wshito/Micromouse2017/freecad/assembly.FCStd

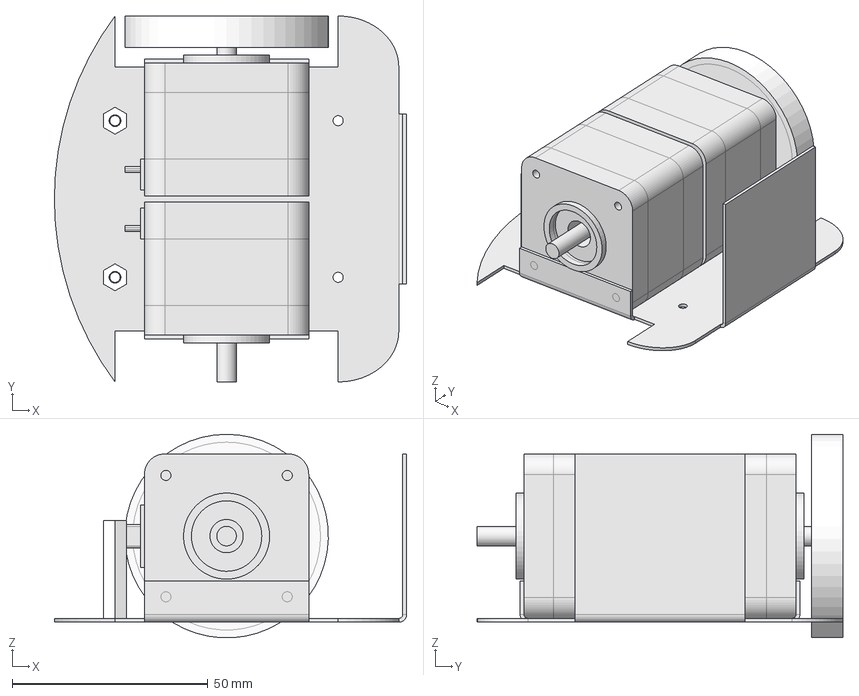
[picture p1: CAD file, 2017-05-07]
freecad/assembly.FCStd
90.0 x 93.5 x 52.0 mm
chassis_01
7PM_K044_left
7PM_K044_right
wheel_right
spacer_M3_25_right
spacer_M3_25_left
