wshito/Micromouse2017/freecad/spacer-M3-25.FCStd

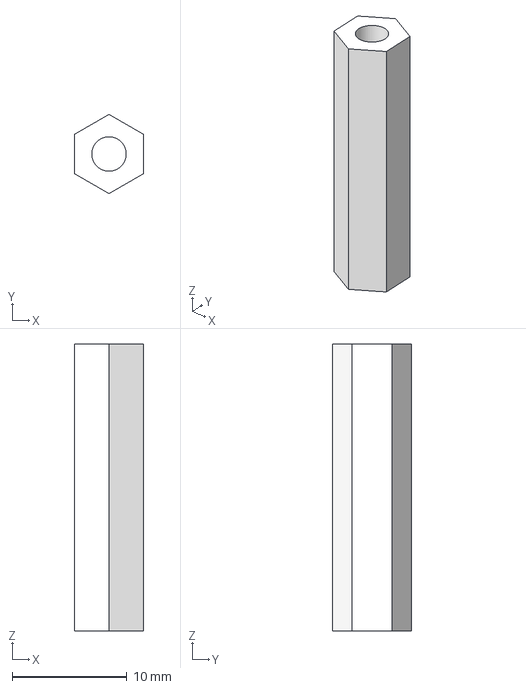
[picture p2: CAD file, 2017-05-07]
freecad/spacer-M3-25.FCStd
5.98 x 6.90 x 25.0 mm
