wshito/Micromouse2017/freecad/17PM-K044.FCStd

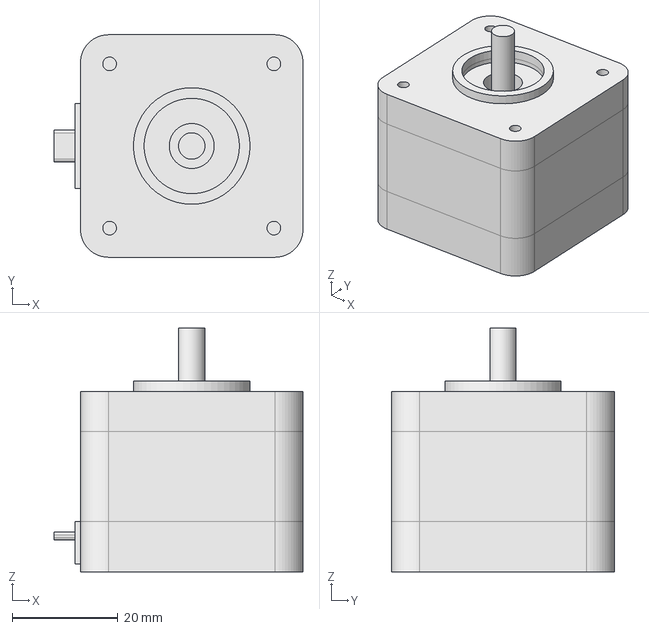
[picture p3: CAD file, 2017-05-07]
freecad/17PM-K044.FCStd
47.0 x 42.0 x 46.0 mm
