wshito/Micromouse2017/freecad/motor-mount.FCStd

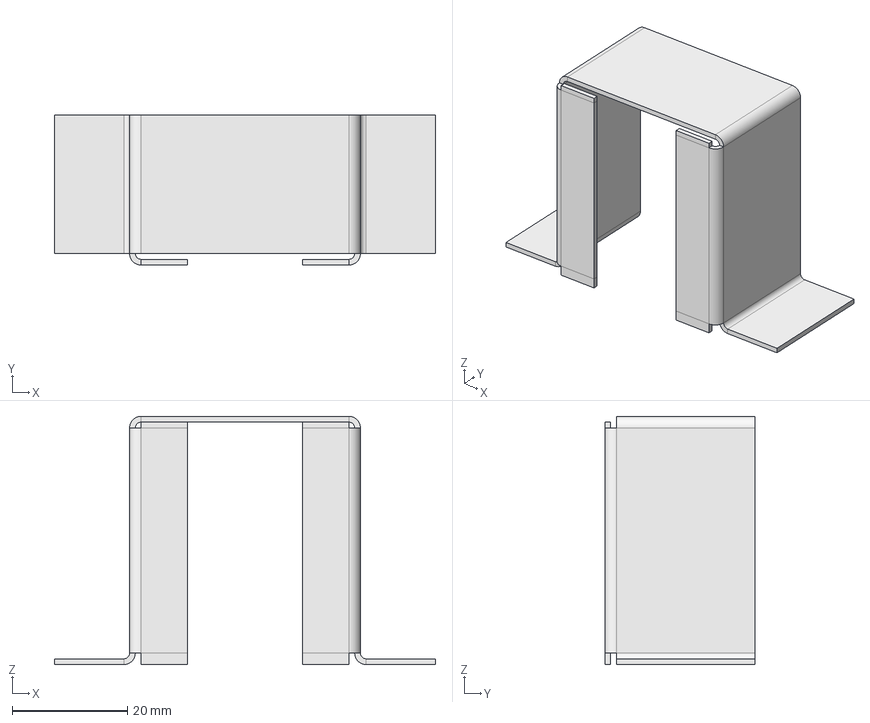
[picture p4: CAD file, 2017-05-06]
freecad/motor-mount.FCStd
66.0 x 26.0 x 43.0 mm
