wshito/Micromouse2017/freecad/chassis.FCStd

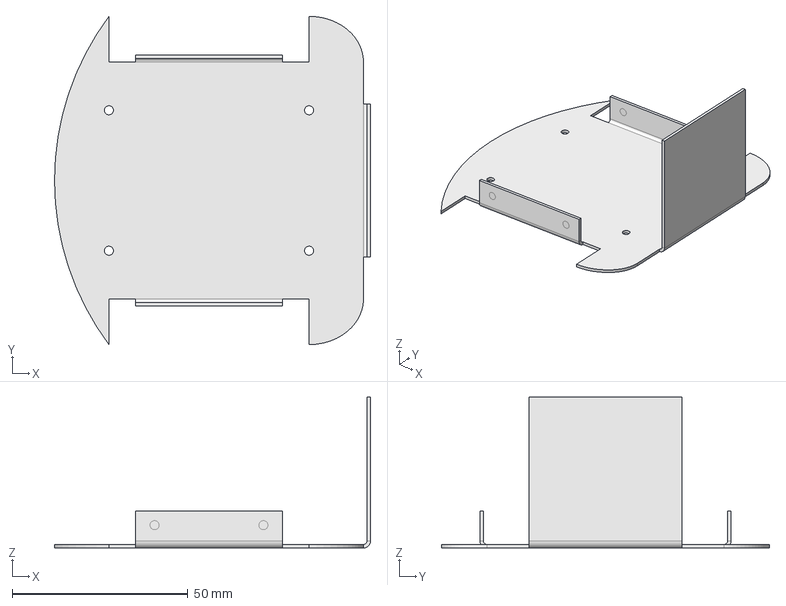
[picture p5: CAD file, 2017-05-06]
freecad/chassis.FCStd
90.0 x 93.5 x 43.0 mm
