wshito/Micromouse2017/freecad/wheel.FCStd

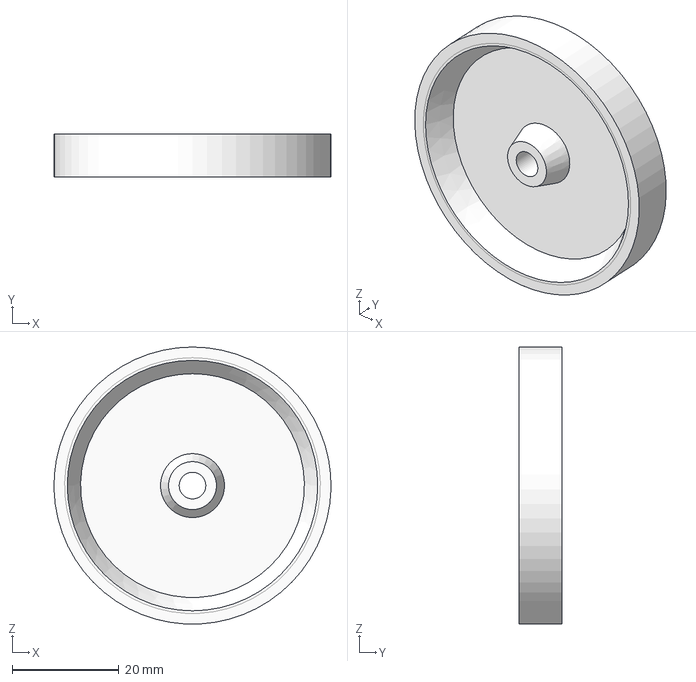
[picture p6: CAD file, 2017-05-06]
freecad/wheel.FCStd
52.0 x 8.00 x 52.0 mm
