wshito/Micromouse2017/prototype/a3982slb_board/kicad/a3982slb_board/output/board_layout.pdf

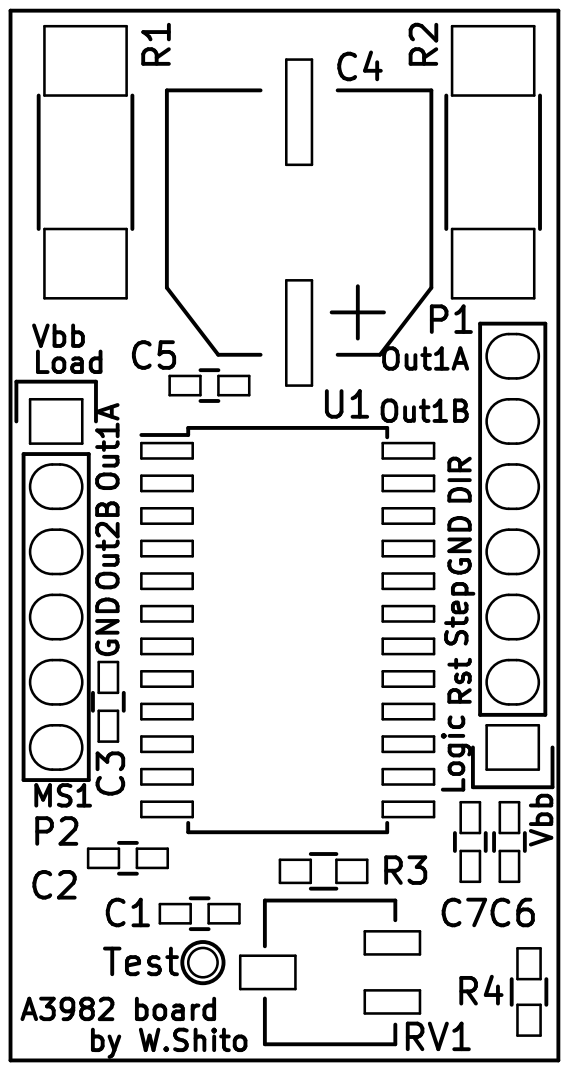
[picture p7: page 1]
