wshito/Micromouse2017/prototype/a3982slb_board/kicad/a3982slb_board/a3982slb_board.kicad_pcb

## KiCad design prototype/a3982slb_board/kicad/a3982slb_board/a3982slb_board.kicad_pcb (2017-07-03)

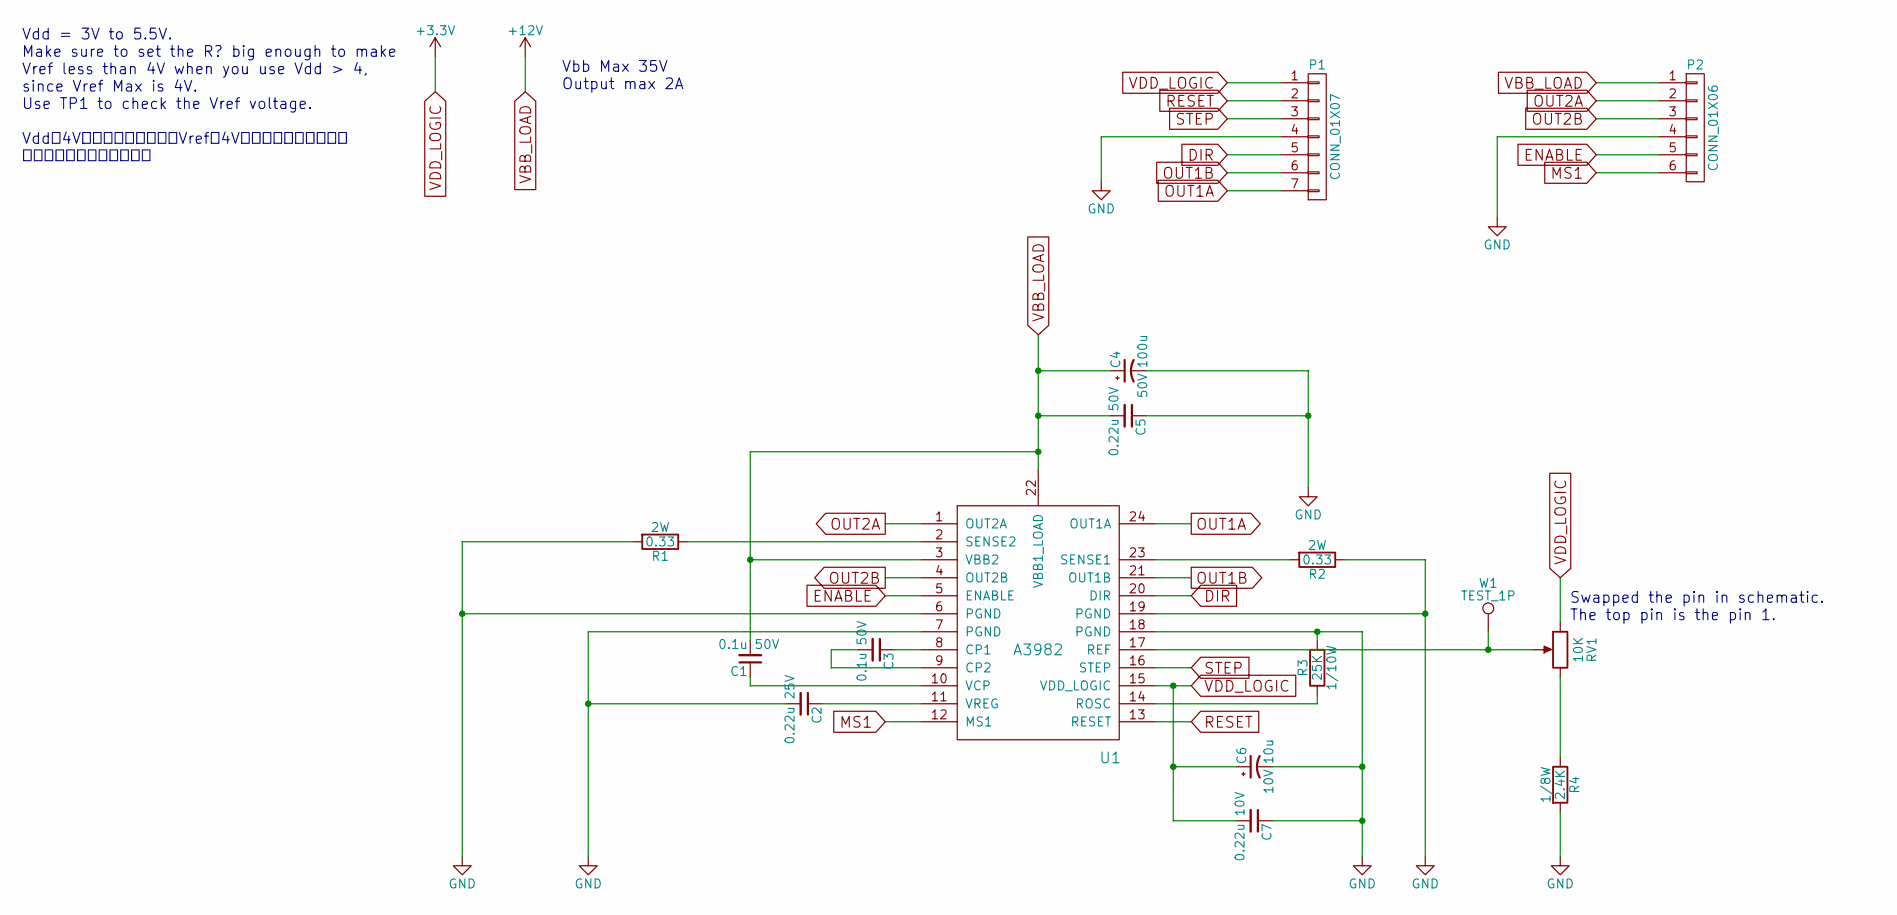
[picture p8: schematic a3982slb_board.sch, A3982 Evaluation Board]

Parts:
C1, C3: 0.1u; C_0603_HandSoldering; Voltage 50V
C2: 0.22u; C_0603_HandSoldering; Voltage 25V
C4: 100u; UCB1H101MNL1GS_HandSoldering; Voltage 50V
C5: 0.22u; C_0603_HandSoldering; Voltage 50V
C6: 10u; C_0603_HandSoldering; Voltage 10V
C7: 0.22u; C_0603_HandSoldering; Voltage 10V
P1: CONN_01X07; Pin_Header_Straight_1x07
P2: CONN_01X06; Pin_Header_Straight_1x06
R1, R2: 0.33; R_2512_HandSoldering
R3: 25K; R_0603_HandSoldering
R4: 2.4K; R_0603_HandSoldering
RV1: 10K; G43A
U1: A3982; SOIC-24W_7.5x15.4mm_Pitch1.27mm
W1: TEST_1P; Measurement_Point_Square-TH_Small

Connections:
DIR: P1.5, U1.20 (DIR)
ENABLE: P2.5, U1.5 (ENABLE)
GND: C2.2, C4.2, C5.1, C6.2, C7.1, P1.4, P2.4, R1.2, R2.1, R3.2, R4.2, U1.6 (PGND), U1.7 (PGND), U1.18 (PGND), U1.19 (PGND)
MS1: P2.6, U1.12 (MS1)
unnamed: C1.1, U1.10 (VCP)
unnamed: C2.1, U1.11 (VREG)
unnamed: C3.1, U1.8 (CP1)
unnamed: C3.2, U1.9 (CP2)
unnamed: R1.1, U1.2 (SENSE2)
unnamed: R2.2, U1.23 (SENSE1)
unnamed: R3.1, U1.14 (ROSC)
unnamed: R4.1, RV1.3
unnamed 12: RV1.2, U1.17 (REF), W1.1; also elsewhere on the board
OUT1A: P1.7, U1.24 (OUT1A)
OUT1B: P1.6, U1.21 (OUT1B)
OUT2A: P2.2, U1.1 (OUT2A)
OUT2B: P2.3, U1.4 (OUT2B)
RESET: P1.2, U1.13 (RESET)
STEP: P1.3, U1.16 (STEP)
VBB_LOAD: C1.2, C4.1, C5.2, P2.1, U1.3 (VBB2), U1.22 (VBB1_LOAD)
VDD_LOGIC: C6.1, C7.2, P1.1, RV1.1, U1.15 (VDD_LOGIC)

Notes on the sheet:
Vdd = 3V to 5.5V. Make sure to set the R? big enough to make Vref less than 4V when you use Vdd > 4, since Vref Max is 4V. Use TP1 to check the Vref voltage. Vddに4V以上印可する場合はVrefに4V以上印可しないように 可変抵抗を調節すること．
Vbb Max 35V Output max 2A
Swapped the pin in schematic. The top pin is the pin 1.

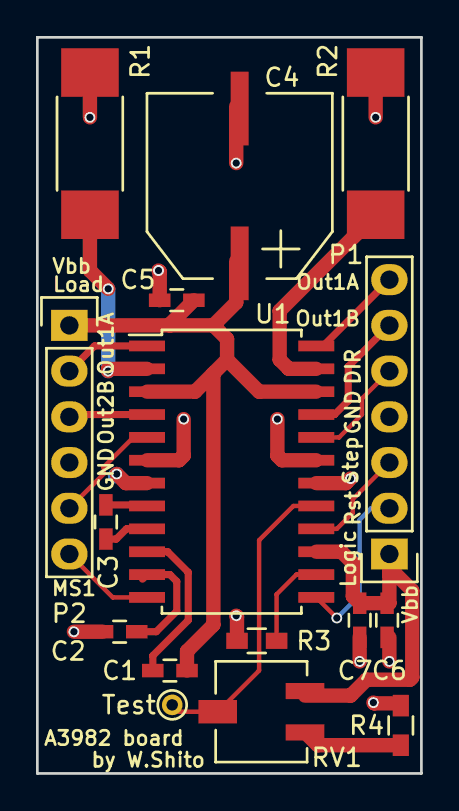
[picture p9: board a3982slb_board.kicad_pcb from above]

Board: 2 copper layers, 21.3 x 40.9 mm, 16 parts (0 on the bottom side), 21 nets.

Other parts of the board:
Test: TEST_1P; PINTST

Their connections:
unnamed 12: Test.1; also elsewhere on the board
