wshito/Micromouse2017/(commit log)

2017-05-04 Created 17PM-K044 stepping motor 3D model.
    [17PM-K044.FCStd]
2017-05-04 Added motor mount 3d cad project.
    [motor-mount.FCStd]
2017-05-04 added kicad ignore files.
2017-05-04 Added kicad micromouse2017 project.
    [micromoust2017.kicad_pcb, micromoust2017.sch]
2017-05-05 fusion succeeded
    [17PM-K044.FCStd]
2017-05-05 final version for the motor.
    [17PM-K044.FCStd]
2017-05-05 basic shape is made.
    [motor-mount.FCStd]
2017-05-06 chassis' first draft.
    [chassis.FCStd]
2017-05-06 Chassis is completed.
    [chassis.FCStd]
2017-05-06 Wire terminal is moved to the other side for assembly workbench.
    [17PM-K044.FCStd]
2017-05-06 Rotated motors are added for assembly purpose.
    [left-motor.FCStd, right-motor.FCStd]
2017-05-06 The width is adjusted.
    [chassis.FCStd]
2017-05-06 The motors are installed.
    [assembly.FCStd]
2017-05-06 Wheel is completed.
    [wheel.FCStd]
2017-05-06 The motor axis is adjusted.
    [17PM-K044.FCStd, chassis.FCStd, left-motor.FCStd, right-motor.FCStd]
2017-05-06 Assembled motors and wheels.
    [assembly.FCStd, right-wheel.FCStd]
2017-05-06 Completed the motor mount design. But it will not be used.
    [motor-mount.FCStd]
2017-05-06 Removed the references to right and left motor and wheel.
    [assembly.FCStd, left-motor.FCStd, right-motor.FCStd, right-wheel.FCStd]
2017-05-07 Added the wire on the motor.
    [17PM-K044.FCStd, assembly.FCStd]
2017-05-07 created M3 20mm spacer.
    [spacer-M3-25.FCStd]
2017-05-07 Added the spacers for the bottom pcb.
    [assembly.FCStd]
2017-05-16 Added A3982 motor driver evaulation board project.
    [a3982slb_board.kicad_pcb, a3982slb_board.sch]
2017-05-22 Routing completed.
    [a3982slb_board.kicad_pcb, a3982slb_board.sch]
2017-05-22 Moved logic GND.
    [a3982slb_board.kicad_pcb]
2017-05-23 Silk is completed. All done.
    [a3982slb_board.kicad_pcb]
2017-05-23 Moved into a3982slb_board folder.
    [a3982slb_board.kicad_pcb, a3982slb_board.sch]
2017-05-23 Added *.kicad_pcb-bak to ignore.
2017-05-24 Started stm32f401rct6 board project.
    [stm32f401rct6_board.kicad_pcb, stm32f401rct6_board.sch]
2017-06-01 USART, boot switches, power supplies are implemented.
    [stm32f401rct6_board.sch]
2017-07-03 Added BOM information on schematic.
    [a3982slb_board.kicad_pcb, a3982slb_board.sch]
2018-02-28 added readme and biproduct files.
    [a3982slb_board.csv]
2018-02-28 added some parts
    [stm32f401rct6_board.sch]
2018-02-28 Reorganized dir layout
    [a3982slb_board.csv, a3982slb_board.kicad_pcb, a3982slb_board.sch]
